futurelink/picnc-epm570/hardware/EPM570_LinuxCNC.kicad_pcb

## KiCad design hardware/EPM570_LinuxCNC.kicad_pcb (2025-01-06)

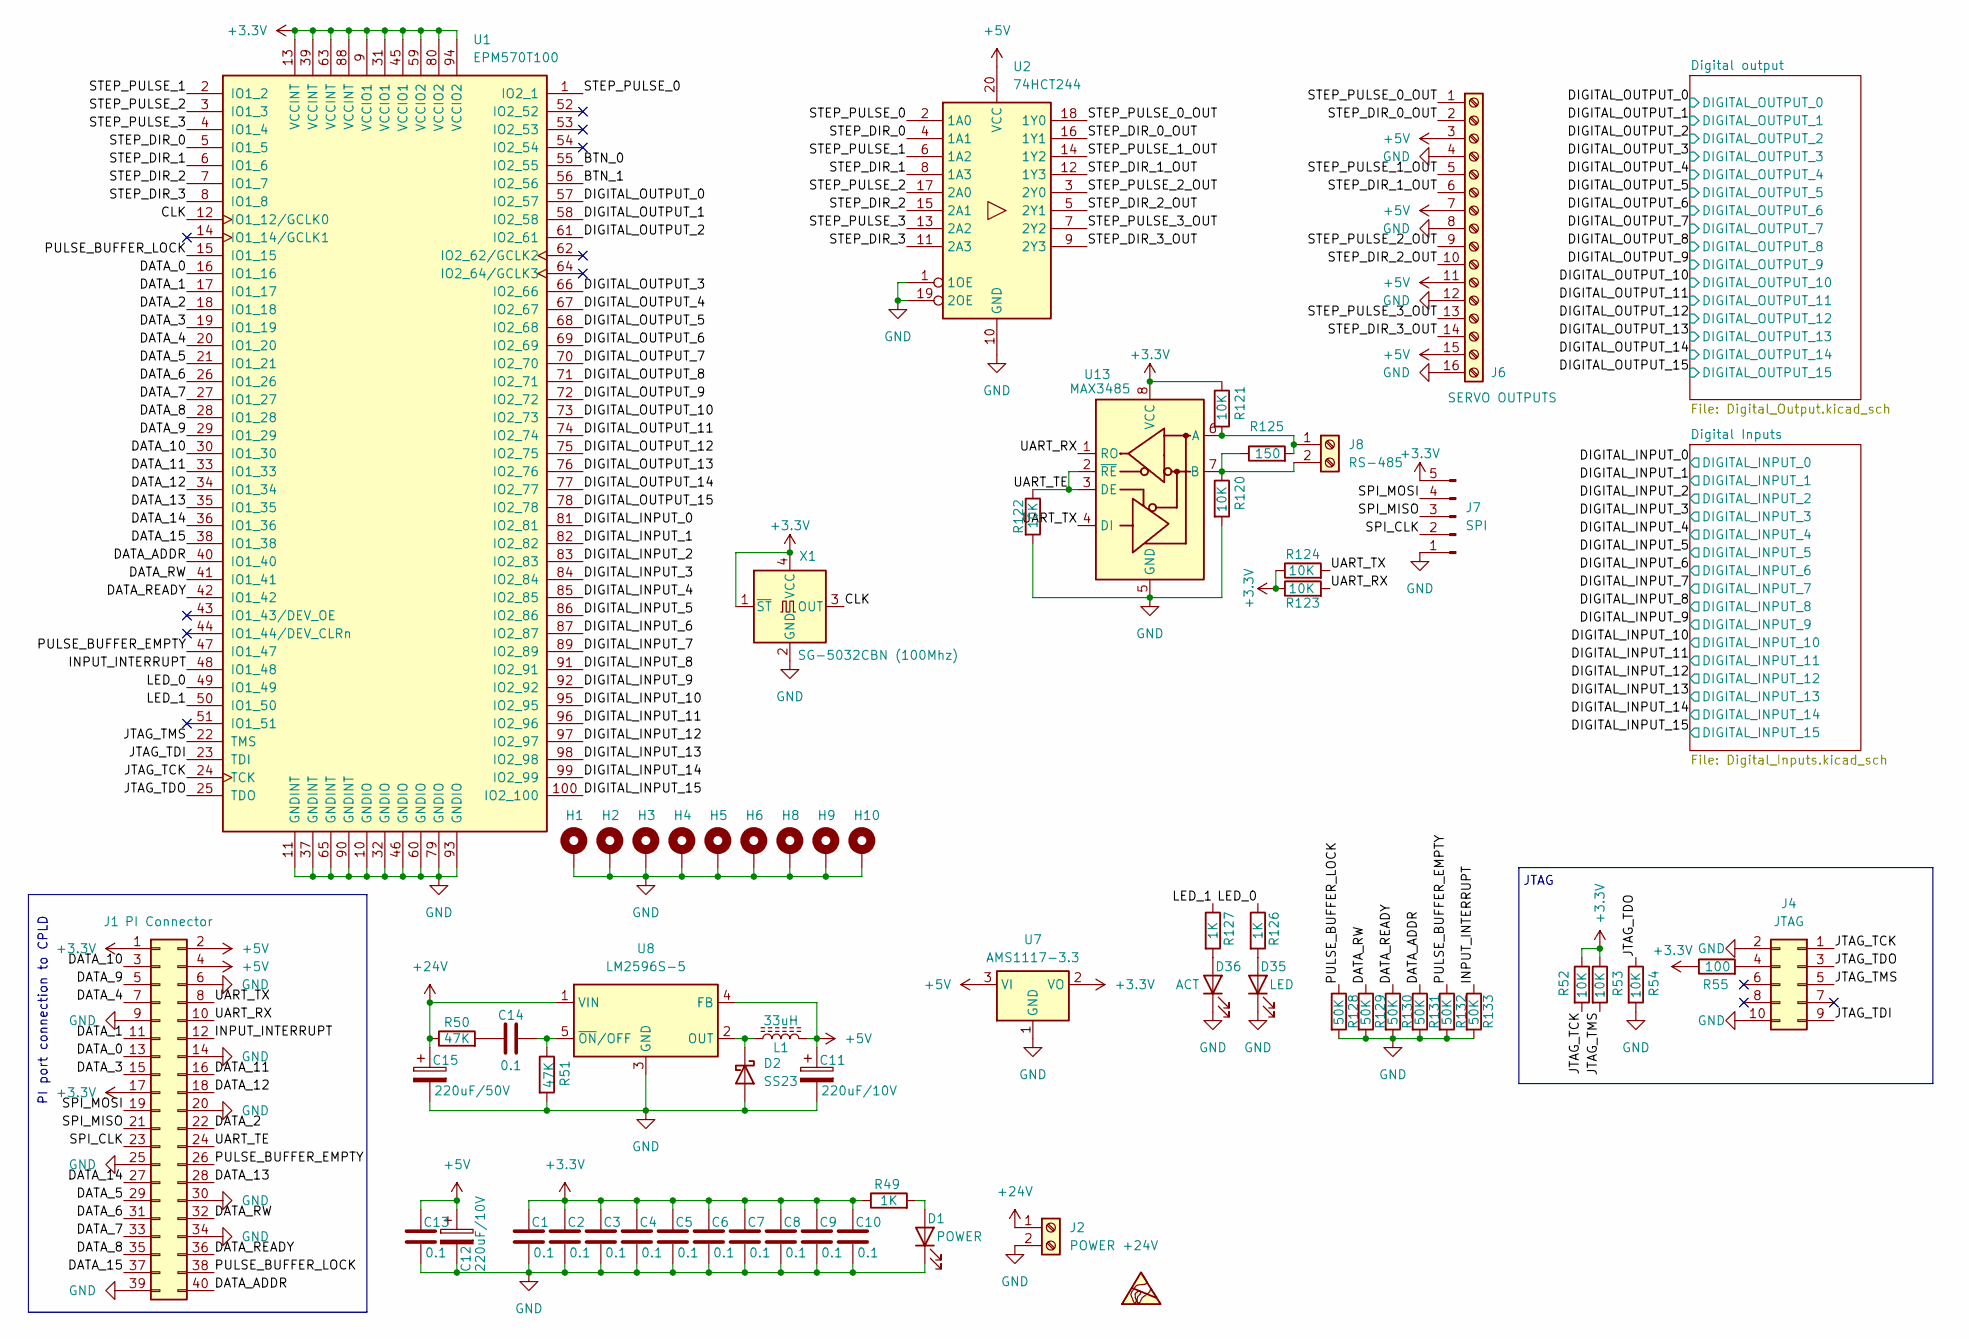
[picture p1: schematic EPM570_LinuxCNC.kicad_sch]

Parts:
C1, C2, C3, C4, C5, C6, C7, C8, C9, C10, C13, C14: 0.1; C_0603_1608Metric
C11, C12: 220uF/10V; CP_Elec_6.3x7.7
C15: 220uF/50V; CP_Elec_10x10
D1: POWER; LED_0603_1608Metric
D2: SS23; D_SMA
D35: LED; LED_0603_1608Metric
D36: ACT; LED_0603_1608Metric
H1, H2, H3, H4, H5, H6: MountingHole_Pad; MountingHole_2.7mm_M2.5_ISO7380_Pad
H8, H9, H10: MountingHole_Pad; MountingHole_3.2mm_M3_ISO7380_Pad
J1: PI Connector; PinSocket_2x20_P2.54mm_Vertical
J2: POWER +24V; TerminalBlock_Xinya_XY308-2.54-2P_1x02_P2.54mm_Horizontal
J4: JTAG; IDC-Header_2x05_P2.54mm_Vertical
J6: SERVO OUTPUTS; TerminalBlock_Xinya_XY308-2.54-16P_1x16_P2.54mm_Horizontal
J7: SPI; JST_EH_S5B-EH_1x05_P2.50mm_Horizontal
J8: RS-485; TerminalBlock_Xinya_XY308-2.54-2P_1x02_P2.54mm_Horizontal
L1: 33uH; L_10.4x10.4_H4.8
R49, R126, R127: 1K; R_0603_1608Metric
R50, R51: 47K; R_0603_1608Metric
R52, R53, R54, R120, R121, R122, R123, R124: 10K; R_0603_1608Metric
R55: 100; R_0603_1608Metric
R125: 150; R_0603_1608Metric
R128, R129, R130, R131, R132, R133: 50K; R_0603_1608Metric
U1: EPM570T100; LQFP-100_14x14mm_P0.5mm
U2: 74HCT244; Infineon_PG-DSO-20-32
U7: AMS1117-3.3; SOT-223-3_TabPin2
U8: LM2596S-5; TO-263-5_TabPin3
U13: MAX3485; SOIC-8_3.9x4.9mm_P1.27mm
X1: SG-5032CBN (100Mhz); Oscillator_SMD_SeikoEpson_SG8002LB-4Pin_5.0x3.2mm

Connections:
+3.3V: C1.1, C2.1, C3.1, C4.1, C5.1, C6.1, C7.1, C8.1, C9.1, C10.1, J1.1, J1.17, J7.5, R49.1, R52.1, R53.1, R55.1, R121.1, R123.1, R124.1, U1.9 (VCCIO1), U1.13 (VCCINT), U1.31 (VCCIO1), U1.39 (VCCINT), U1.45 (VCCIO1), U1.59 (VCCIO2), U1.63 (VCCINT), U1.80 (VCCIO2), U1.88 (VCCINT), U1.94 (VCCIO2), U7.2 (VO), U13.8 (VCC), X1.1 (~ST), X1.4 (VCC); also elsewhere on the board
+5V: C11.1, C12.1, C13.1, J1.2, J1.4, J6.3, J6.7, J6.11, J6.15, L1.2, U2.20 (VCC), U7.3 (VI), U8.4 (FB); also elsewhere on the board
+24V: C15.1, J2.1, R50.1, U8.1 (VIN)
/BTN_0: U1.55 (IO2_55)
/BTN_1: U1.56 (IO2_56)
/CLK: U1.12 (IO1_12/GCLK0), X1.3 (OUT)
/DATA_0: J1.13, U1.16 (IO1_16)
/DATA_1: J1.11, U1.17 (IO1_17)
/DATA_2: J1.22, U1.18 (IO1_18)
/DATA_3: J1.15, U1.19 (IO1_19)
/DATA_4: J1.7, U1.20 (IO1_20)
/DATA_5: J1.29, U1.21 (IO1_21)
/DATA_6: J1.31, U1.26 (IO1_26)
/DATA_7: J1.33, U1.27 (IO1_27)
/DATA_8: J1.35, U1.28 (IO1_28)
/DATA_9: J1.5, U1.29 (IO1_29)
/DATA_10: J1.3, U1.30 (IO1_30)
/DATA_11: J1.16, U1.33 (IO1_33)
/DATA_12: J1.18, U1.34 (IO1_34)
/DATA_13: J1.28, U1.35 (IO1_35)
/DATA_14: J1.27, U1.36 (IO1_36)
/DATA_15: J1.37, U1.38 (IO1_38)
/DATA_ADDR: J1.40, R131.1, U1.40 (IO1_40)
/DATA_READY: J1.36, R130.1, U1.42 (IO1_42)
/DATA_RW: J1.32, R129.1, U1.41 (IO1_41)
/DIGITAL_INPUT_0: U1.81 (IO2_81); also elsewhere on the board
/DIGITAL_INPUT_1: U1.82 (IO2_82); also elsewhere on the board
/DIGITAL_INPUT_2: U1.83 (IO2_83); also elsewhere on the board
/DIGITAL_INPUT_3: U1.84 (IO2_84); also elsewhere on the board
/DIGITAL_INPUT_4: U1.85 (IO2_85); also elsewhere on the board
/DIGITAL_INPUT_5: U1.86 (IO2_86); also elsewhere on the board
/DIGITAL_INPUT_6: U1.87 (IO2_87); also elsewhere on the board
/DIGITAL_INPUT_7: U1.89 (IO2_89); also elsewhere on the board
/DIGITAL_INPUT_8: U1.91 (IO2_91); also elsewhere on the board
/DIGITAL_INPUT_9: U1.92 (IO2_92); also elsewhere on the board
/DIGITAL_INPUT_10: U1.95 (IO2_95); also elsewhere on the board
/DIGITAL_INPUT_11: U1.96 (IO2_96); also elsewhere on the board
/DIGITAL_INPUT_12: U1.97 (IO2_97); also elsewhere on the board
/DIGITAL_INPUT_13: U1.98 (IO2_98); also elsewhere on the board
/DIGITAL_INPUT_14: U1.99 (IO2_99); also elsewhere on the board
/DIGITAL_INPUT_15: U1.100 (IO2_100); also elsewhere on the board
/DIGITAL_OUTPUT_0: U1.57 (IO2_57); also elsewhere on the board
/DIGITAL_OUTPUT_1: U1.58 (IO2_58); also elsewhere on the board
/DIGITAL_OUTPUT_2: U1.61 (IO2_61); also elsewhere on the board
/DIGITAL_OUTPUT_3: U1.66 (IO2_66); also elsewhere on the board
/DIGITAL_OUTPUT_4: U1.67 (IO2_67); also elsewhere on the board
/DIGITAL_OUTPUT_5: U1.68 (IO2_68); also elsewhere on the board
/DIGITAL_OUTPUT_6: U1.69 (IO2_69); also elsewhere on the board
/DIGITAL_OUTPUT_7: U1.70 (IO2_70); also elsewhere on the board
/DIGITAL_OUTPUT_8: U1.71 (IO2_71); also elsewhere on the board
/DIGITAL_OUTPUT_9: U1.72 (IO2_72); also elsewhere on the board
/DIGITAL_OUTPUT_10: U1.73 (IO2_73); also elsewhere on the board
/DIGITAL_OUTPUT_11: U1.74 (IO2_74); also elsewhere on the board
/DIGITAL_OUTPUT_12: U1.75 (IO2_75); also elsewhere on the board
/DIGITAL_OUTPUT_13: U1.76 (IO2_76); also elsewhere on the board
/DIGITAL_OUTPUT_14: U1.77 (IO2_77); also elsewhere on the board
/DIGITAL_OUTPUT_15: U1.78 (IO2_78); also elsewhere on the board
/INPUT_INTERRUPT: J1.12, R133.1, U1.48 (IO1_48)
/JTAG_TCK: J4.1, R52.2, U1.24 (TCK)
/JTAG_TDI: J4.9, U1.23 (TDI)
/JTAG_TDO: J4.3, R54.1, U1.25 (TDO)
/JTAG_TMS: J4.5, R53.2, U1.22 (TMS)
/LED_0: R126.1, U1.49 (IO1_49)
/LED_1: R127.1, U1.50 (IO1_50)
/PULSE_BUFFER_EMPTY: J1.26, R132.1, U1.47 (IO1_47)
/PULSE_BUFFER_LOCK: J1.38, R128.1, U1.15 (IO1_15)
/SPI_CLK: J1.23, J7.2
/SPI_MISO: J1.21, J7.3
/SPI_MOSI: J1.19, J7.4
/STEP_DIR_0: U1.5 (IO1_5), U2.4 (1A1)
/STEP_DIR_0_OUT: J6.2, U2.16 (1Y1)
/STEP_DIR_1: U1.6 (IO1_6), U2.8 (1A3)
/STEP_DIR_1_OUT: J6.6, U2.12 (1Y3)
/STEP_DIR_2: U1.7 (IO1_7), U2.15 (2A1)
/STEP_DIR_2_OUT: J6.10, U2.5 (2Y1)
/STEP_DIR_3: U1.8 (IO1_8), U2.11 (2A3)
/STEP_DIR_3_OUT: J6.14, U2.9 (2Y3)
/STEP_PULSE_0: U1.1 (IO2_1), U2.2 (1A0)
/STEP_PULSE_0_OUT: J6.1, U2.18 (1Y0)
/STEP_PULSE_1: U1.2 (IO1_2), U2.6 (1A2)
/STEP_PULSE_1_OUT: J6.5, U2.14 (1Y2)
/STEP_PULSE_2: U1.3 (IO1_3), U2.17 (2A0)
/STEP_PULSE_2_OUT: J6.9, U2.3 (2Y0)
/STEP_PULSE_3: U1.4 (IO1_4), U2.13 (2A2)
/STEP_PULSE_3_OUT: J6.13, U2.7 (2Y2)
/UART_RX: J1.10, R123.2, U13.1 (RO)
/UART_TE: J1.24, R122.1, U13.2 (~RE), U13.3 (DE)
/UART_TX: J1.8, R124.2, U13.4 (DI)
GND: C1.2, C2.2, C3.2, C4.2, C5.2, C6.2, C7.2, C8.2, C9.2, C10.2, C11.2, C12.2, C13.2, C15.2, D1.1 (K), D2.2 (A), D35.1 (K), D36.1 (K), H1.1, H2.1, H3.1, H4.1, H5.1, H6.1, H8.1, H9.1, H10.1, J1.6, J1.9, J1.14, J1.20, J1.25, J1.30, J1.34, J1.39, J2.2, J4.2, J4.10, J6.4, J6.8, J6.12, J6.16, J7.1, R51.2, R54.2, R120.2, R122.2, R128.2, R129.2, R130.2, R131.2, R132.2, R133.2, U1.10 (GNDIO), U1.11 (GNDINT), U1.32 (GNDIO), U1.37 (GNDINT), U1.46 (GNDIO), U1.60 (GNDIO), U1.65 (GNDINT), U1.79 (GNDIO), U1.90 (GNDINT), U1.93 (GNDIO), U2.1 (1OE), U2.10 (GND), U2.19 (2OE), U7.1 (GND), U8.3 (GND), U13.5 (GND), X1.2 (GND); also elsewhere on the board
unnamed: C14.1, R50.2
unnamed: D1.2 (A), R49.2
unnamed: D2.1 (K), L1.1, U8.2 (OUT)
unnamed: D35.2 (A), R126.2
unnamed: D36.2 (A), R127.2
unnamed: J4.4, R55.2
unnamed: J8.1, R121.2, R125.2, U13.6 (A)
unnamed: J8.2, R120.1, R125.1, U13.7 (B)
unnamed: C14.2, R51.1, U8.5 (~ON/OFF)

Notes on the sheet:
PI port connection to CPLD
JTAG

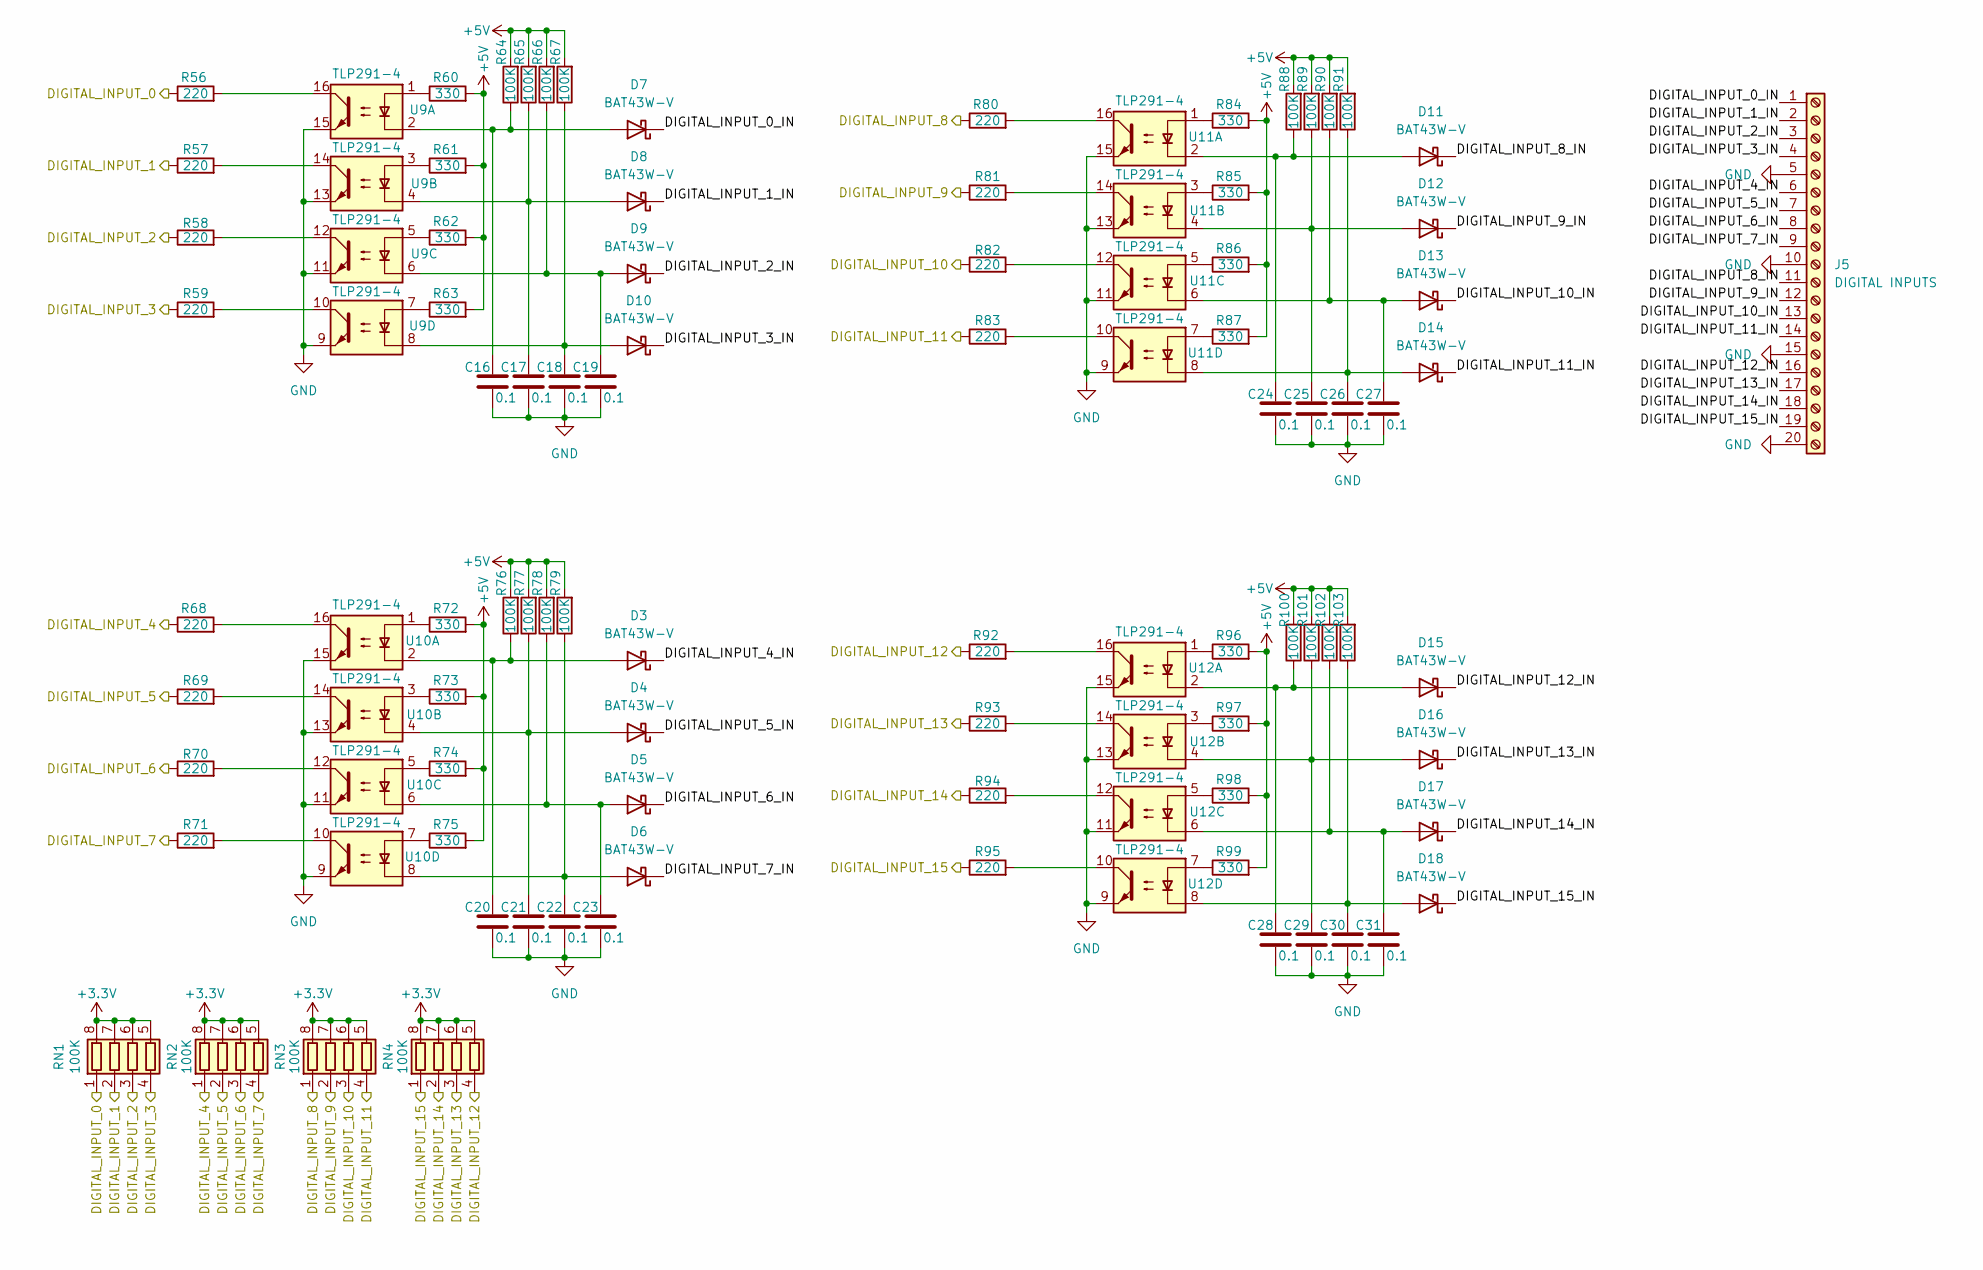
[picture p2: schematic Digital_Inputs.kicad_sch]

Parts:
C16, C17, C18, C19, C20, C21, C22, C23, C24, C25, C26, C27, C28, C29, C30, C31: 0.1; C_0603_1608Metric
D3, D4, D5, D6, D7, D8, D9, D10, D11, D12, D13, D14, D15, D16, D17, D18: BAT43W-V; D_SOD-323
J5: DIGITAL INPUTS; TerminalBlock_Xinya_XY308-2.54-20P_1x20_P2.54mm_Horizontal
R56, R57, R58, R59, R68, R69, R70, R71, R80, R81, R82, R83, R92, R93, R94, R95: 220; R_0603_1608Metric
R60, R61, R62, R63, R72, R73, R74, R75, R84, R85, R86, R87, R96, R97, R98, R99: 330; R_0603_1608Metric
R64, R65, R66, R67, R76, R77, R78, R79, R88, R89, R90, R91, R100, R101, R102, R103: 100K; R_0603_1608Metric
RN1, RN2, RN3, RN4: 100K; R_Array_Convex_4x0603
U9, U10, U11, U12: TLP291-4; SOIC-16_4.55x10.3mm_P1.27mm

Connections:
+3.3V: RN1.5 (R4.2), RN1.6 (R3.2), RN1.7 (R2.2), RN1.8 (R1.2), RN2.5 (R4.2), RN2.6 (R3.2), RN2.7 (R2.2), RN2.8 (R1.2), RN3.5 (R4.2), RN3.6 (R3.2), RN3.7 (R2.2), RN3.8 (R1.2), RN4.5 (R4.2), RN4.6 (R3.2), RN4.7 (R2.2), RN4.8 (R1.2); also elsewhere on the board
+5V: R60.2, R61.2, R62.2, R63.2, R64.2, R65.2, R66.2, R67.2, R72.2, R73.2, R74.2, R75.2, R76.2, R77.2, R78.2, R79.2, R84.2, R85.2, R86.2, R87.2, R88.2, R89.2, R90.2, R91.2, R96.2, R97.2, R98.2, R99.2, R100.2, R101.2, R102.2, R103.2; also elsewhere on the board
/DIGITAL_INPUT_0: R56.1, RN1.1 (R1.1); also elsewhere on the board
/DIGITAL_INPUT_1: R57.1, RN1.2 (R2.1); also elsewhere on the board
/DIGITAL_INPUT_2: R58.1, RN1.3 (R3.1); also elsewhere on the board
/DIGITAL_INPUT_3: R59.1, RN1.4 (R4.1); also elsewhere on the board
/DIGITAL_INPUT_4: R68.1, RN2.1 (R1.1); also elsewhere on the board
/DIGITAL_INPUT_5: R69.1, RN2.2 (R2.1); also elsewhere on the board
/DIGITAL_INPUT_6: R70.1, RN2.3 (R3.1); also elsewhere on the board
/DIGITAL_INPUT_7: R71.1, RN2.4 (R4.1); also elsewhere on the board
/DIGITAL_INPUT_8: R80.1, RN3.1 (R1.1); also elsewhere on the board
/DIGITAL_INPUT_9: R81.1, RN3.2 (R2.1); also elsewhere on the board
/DIGITAL_INPUT_10: R82.1, RN3.3 (R3.1); also elsewhere on the board
/DIGITAL_INPUT_11: R83.1, RN3.4 (R4.1); also elsewhere on the board
/DIGITAL_INPUT_12: R92.1, RN4.4 (R4.1); also elsewhere on the board
/DIGITAL_INPUT_13: R93.1, RN4.3 (R3.1); also elsewhere on the board
/DIGITAL_INPUT_14: R94.1, RN4.2 (R2.1); also elsewhere on the board
/DIGITAL_INPUT_15: R95.1, RN4.1 (R1.1); also elsewhere on the board
/Digital Inputs/DIGITAL_INPUT_0_IN: D7.1 (K), J5.1
/Digital Inputs/DIGITAL_INPUT_1_IN: D8.1 (K), J5.2
/Digital Inputs/DIGITAL_INPUT_2_IN: D9.1 (K), J5.3
/Digital Inputs/DIGITAL_INPUT_3_IN: D10.1 (K), J5.4
/Digital Inputs/DIGITAL_INPUT_4_IN: D3.1 (K), J5.6
/Digital Inputs/DIGITAL_INPUT_5_IN: D4.1 (K), J5.7
/Digital Inputs/DIGITAL_INPUT_6_IN: D5.1 (K), J5.8
/Digital Inputs/DIGITAL_INPUT_7_IN: D6.1 (K), J5.9
/Digital Inputs/DIGITAL_INPUT_8_IN: D11.1 (K), J5.11
/Digital Inputs/DIGITAL_INPUT_9_IN: D12.1 (K), J5.12
/Digital Inputs/DIGITAL_INPUT_10_IN: D13.1 (K), J5.13
/Digital Inputs/DIGITAL_INPUT_11_IN: D14.1 (K), J5.14
/Digital Inputs/DIGITAL_INPUT_12_IN: D15.1 (K), J5.16
/Digital Inputs/DIGITAL_INPUT_13_IN: D16.1 (K), J5.17
/Digital Inputs/DIGITAL_INPUT_14_IN: D17.1 (K), J5.18
/Digital Inputs/DIGITAL_INPUT_15_IN: D18.1 (K), J5.19
GND: C16.2, C17.2, C18.2, C19.2, C20.2, C21.2, C22.2, C23.2, C24.2, C25.2, C26.2, C27.2, C28.2, C29.2, C30.2, C31.2, J5.5, J5.10, J5.15, J5.20, U9.9, U9.11, U9.13, U9.15, U10.9, U10.11, U10.13, U10.15, U11.9, U11.11, U11.13, U11.15, U12.9, U12.11, U12.13, U12.15; also elsewhere on the board
unnamed: C20.1, D3.2 (A), R76.1, U10.2
unnamed: C21.1, D4.2 (A), R77.1, U10.4
unnamed: C23.1, D5.2 (A), R78.1, U10.6
unnamed: C22.1, D6.2 (A), R79.1, U10.8
unnamed: C16.1, D7.2 (A), R64.1, U9.2
unnamed: C17.1, D8.2 (A), R65.1, U9.4
unnamed: C19.1, D9.2 (A), R66.1, U9.6
unnamed: C18.1, D10.2 (A), R67.1, U9.8
unnamed: C24.1, D11.2 (A), R88.1, U11.2
unnamed: C25.1, D12.2 (A), R89.1, U11.4
unnamed: C27.1, D13.2 (A), R90.1, U11.6
unnamed: C26.1, D14.2 (A), R91.1, U11.8
unnamed: C28.1, D15.2 (A), R100.1, U12.2
unnamed: C29.1, D16.2 (A), R101.1, U12.4
unnamed: C31.1, D17.2 (A), R102.1, U12.6
unnamed: C30.1, D18.2 (A), R103.1, U12.8
unnamed: R56.2, U9.16
unnamed: R57.2, U9.14
unnamed: R58.2, U9.12
unnamed: R59.2, U9.10
unnamed: R60.1, U9.1
unnamed: R61.1, U9.3
unnamed: R62.1, U9.5
unnamed: R63.1, U9.7
unnamed: R68.2, U10.16
unnamed: R69.2, U10.14
unnamed: R70.2, U10.12
unnamed: R71.2, U10.10
unnamed: R72.1, U10.1
unnamed: R73.1, U10.3
unnamed: R74.1, U10.5
unnamed: R75.1, U10.7
unnamed: R80.2, U11.16
unnamed: R81.2, U11.14
unnamed: R82.2, U11.12
unnamed: R83.2, U11.10
unnamed: R84.1, U11.1
unnamed: R85.1, U11.3
unnamed: R86.1, U11.5
unnamed: R87.1, U11.7
unnamed: R92.2, U12.16
unnamed: R93.2, U12.14
unnamed: R94.2, U12.12
unnamed: R95.2, U12.10
unnamed: R96.1, U12.1
unnamed: R97.1, U12.3
unnamed: R98.1, U12.5
unnamed: R99.1, U12.7

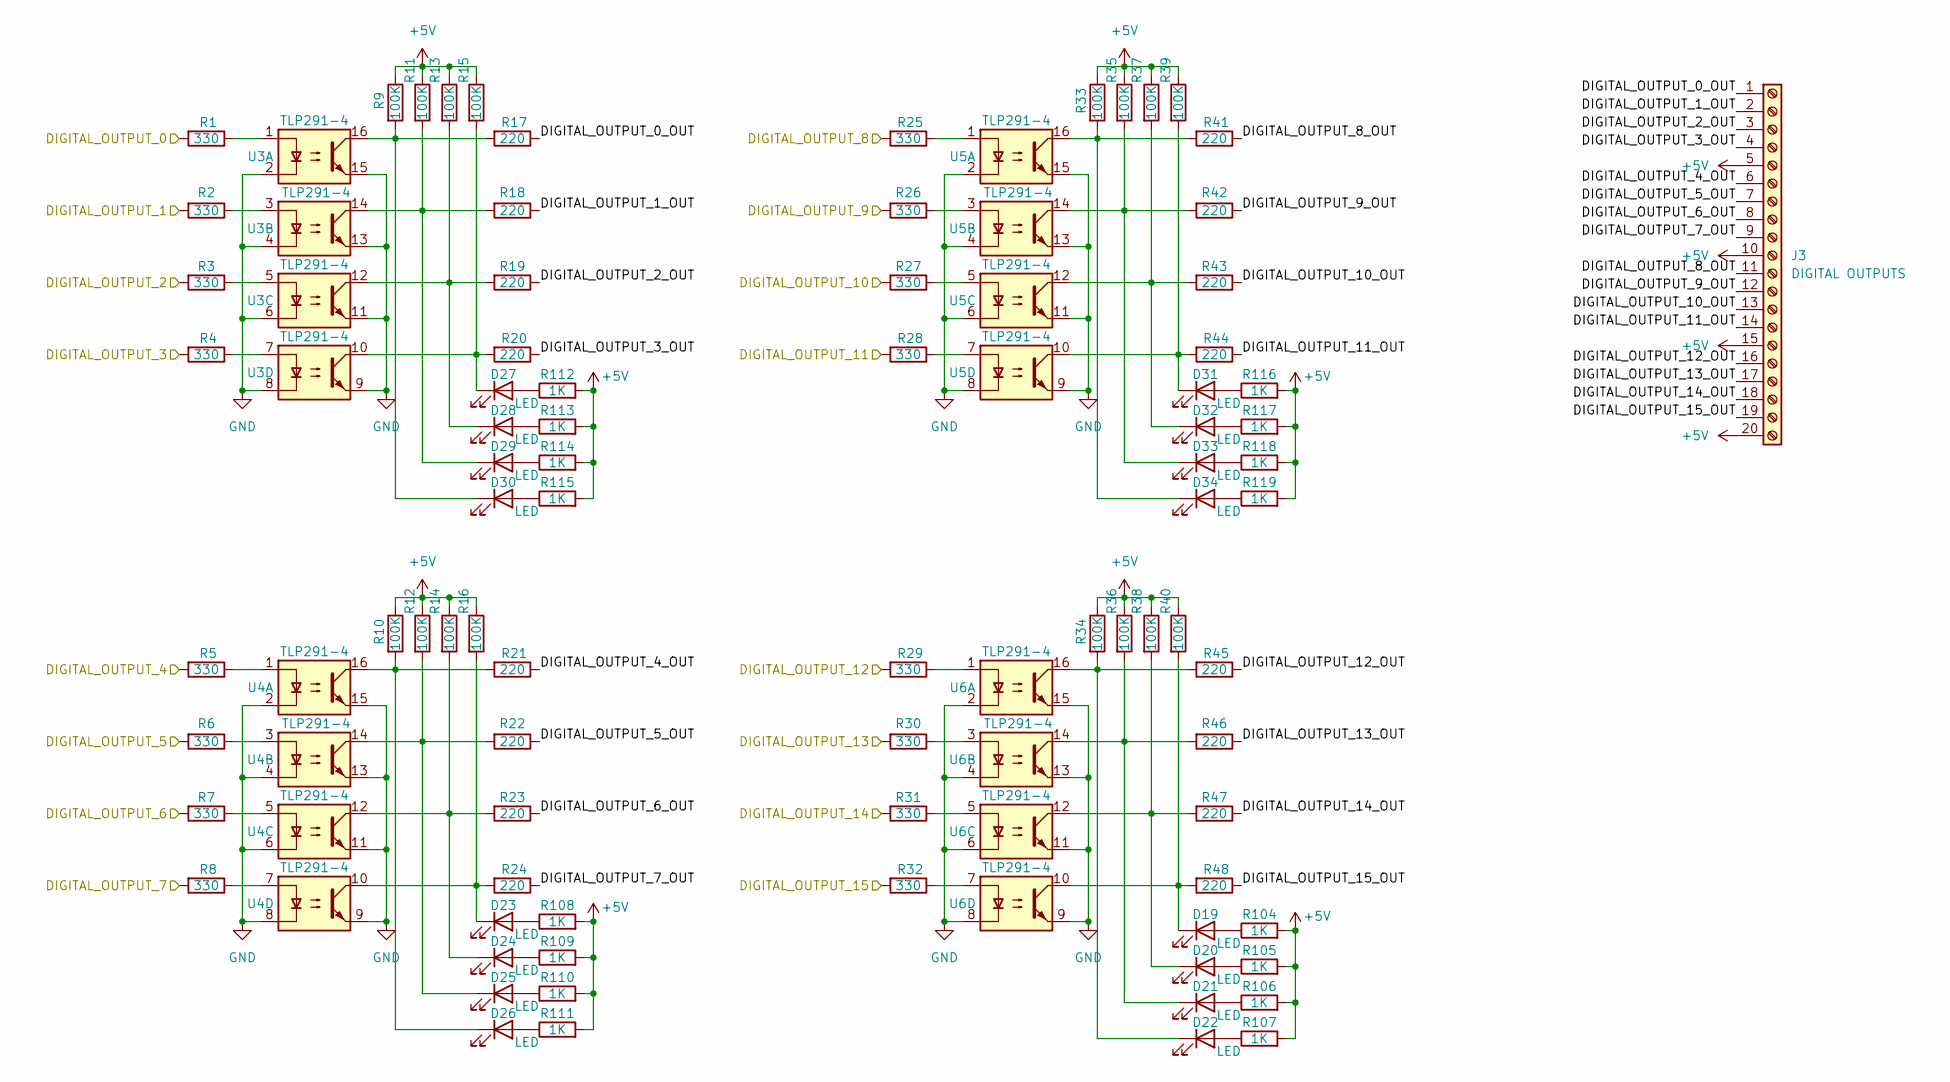
[picture p3: schematic Digital_Output.kicad_sch]

Parts:
D19, D20, D21, D22, D23, D24, D25, D26, D27, D28, D29, D30, D31, D32, D33, D34: LED; LED_0603_1608Metric
J3: DIGITAL OUTPUTS; TerminalBlock_Xinya_XY308-2.54-20P_1x20_P2.54mm_Horizontal
R1, R2, R3, R4, R5, R6, R7, R8, R25, R26, R27, R28, R29, R30, R31, R32: 330; R_0603_1608Metric
R9, R10, R11, R12, R13, R14, R15, R16, R33, R34, R35, R36, R37, R38, R39, R40: 100K; R_0603_1608Metric
R17, R18, R19, R20, R21, R22, R23, R24, R41, R42, R43, R44, R45, R46, R47, R48: 220; R_0603_1608Metric
R104, R105, R106, R107, R108, R109, R110, R111, R112, R113, R114, R115, R116, R117, R118, R119: 1K; R_0603_1608Metric
U3, U4, U5, U6: TLP291-4; SOIC-16_4.55x10.3mm_P1.27mm

Connections:
+5V: J3.5, J3.10, J3.15, J3.20, R9.1, R10.1, R11.1, R12.1, R13.1, R14.1, R15.1, R16.1, R33.1, R34.1, R35.1, R36.1, R37.1, R38.1, R39.1, R40.1, R104.2, R105.2, R106.2, R107.2, R108.2, R109.2, R110.2, R111.2, R112.2, R113.2, R114.2, R115.2, R116.2, R117.2, R118.2, R119.2; also elsewhere on the board
/DIGITAL_OUTPUT_0: R1.2; also elsewhere on the board
/DIGITAL_OUTPUT_1: R2.2; also elsewhere on the board
/DIGITAL_OUTPUT_2: R3.2; also elsewhere on the board
/DIGITAL_OUTPUT_3: R4.2; also elsewhere on the board
/DIGITAL_OUTPUT_4: R5.2; also elsewhere on the board
/DIGITAL_OUTPUT_5: R6.2; also elsewhere on the board
/DIGITAL_OUTPUT_6: R7.2; also elsewhere on the board
/DIGITAL_OUTPUT_7: R8.2; also elsewhere on the board
/DIGITAL_OUTPUT_8: R25.2; also elsewhere on the board
/DIGITAL_OUTPUT_9: R26.2; also elsewhere on the board
/DIGITAL_OUTPUT_10: R27.2; also elsewhere on the board
/DIGITAL_OUTPUT_11: R28.2; also elsewhere on the board
/DIGITAL_OUTPUT_12: R29.2; also elsewhere on the board
/DIGITAL_OUTPUT_13: R30.2; also elsewhere on the board
/DIGITAL_OUTPUT_14: R31.2; also elsewhere on the board
/DIGITAL_OUTPUT_15: R32.2; also elsewhere on the board
/Digital output/DIGITAL_OUTPUT_0_OUT: J3.1, R17.1
/Digital output/DIGITAL_OUTPUT_1_OUT: J3.2, R18.1
/Digital output/DIGITAL_OUTPUT_2_OUT: J3.3, R19.1
/Digital output/DIGITAL_OUTPUT_3_OUT: J3.4, R20.1
/Digital output/DIGITAL_OUTPUT_4_OUT: J3.6, R21.1
/Digital output/DIGITAL_OUTPUT_5_OUT: J3.7, R22.1
/Digital output/DIGITAL_OUTPUT_6_OUT: J3.8, R23.1
/Digital output/DIGITAL_OUTPUT_7_OUT: J3.9, R24.1
/Digital output/DIGITAL_OUTPUT_8_OUT: J3.11, R41.1
/Digital output/DIGITAL_OUTPUT_9_OUT: J3.12, R42.1
/Digital output/DIGITAL_OUTPUT_10_OUT: J3.13, R43.1
/Digital output/DIGITAL_OUTPUT_11_OUT: J3.14, R44.1
/Digital output/DIGITAL_OUTPUT_12_OUT: J3.16, R45.1
/Digital output/DIGITAL_OUTPUT_13_OUT: J3.17, R46.1
/Digital output/DIGITAL_OUTPUT_14_OUT: J3.18, R47.1
/Digital output/DIGITAL_OUTPUT_15_OUT: J3.19, R48.1
GND: U3.2, U3.4, U3.6, U3.8, U3.9, U3.11, U3.13, U3.15, U4.2, U4.4, U4.6, U4.8, U4.9, U4.11, U4.13, U4.15, U5.2, U5.4, U5.6, U5.8, U5.9, U5.11, U5.13, U5.15, U6.2, U6.4, U6.6, U6.8, U6.9, U6.11, U6.13, U6.15; also elsewhere on the board
unnamed: D19.2 (A), R104.1
unnamed: D19.1 (K), R40.2, R48.2, U6.10
unnamed: D20.2 (A), R105.1
unnamed: D20.1 (K), R38.2, R47.2, U6.12
unnamed: D21.2 (A), R106.1
unnamed: D21.1 (K), R36.2, R46.2, U6.14
unnamed: D22.2 (A), R107.1
unnamed: D22.1 (K), R34.2, R45.2, U6.16
unnamed: D23.2 (A), R108.1
unnamed: D23.1 (K), R16.2, R24.2, U4.10
unnamed: D24.2 (A), R109.1
unnamed: D24.1 (K), R14.2, R23.2, U4.12
unnamed: D25.2 (A), R110.1
unnamed: D25.1 (K), R12.2, R22.2, U4.14
unnamed: D26.2 (A), R111.1
unnamed: D26.1 (K), R10.2, R21.2, U4.16
unnamed: D27.2 (A), R112.1
unnamed: D27.1 (K), R15.2, R20.2, U3.10
unnamed: D28.2 (A), R113.1
unnamed: D28.1 (K), R13.2, R19.2, U3.12
unnamed: D29.2 (A), R114.1
unnamed: D29.1 (K), R11.2, R18.2, U3.14
unnamed: D30.2 (A), R115.1
unnamed: D30.1 (K), R9.2, R17.2, U3.16
unnamed: D31.2 (A), R116.1
unnamed: D31.1 (K), R39.2, R44.2, U5.10
unnamed: D32.2 (A), R117.1
unnamed: D32.1 (K), R37.2, R43.2, U5.12
unnamed: D33.2 (A), R118.1
unnamed: D33.1 (K), R35.2, R42.2, U5.14
unnamed: D34.2 (A), R119.1
unnamed: D34.1 (K), R33.2, R41.2, U5.16
unnamed: R1.1, U3.1
unnamed: R2.1, U3.3
unnamed: R3.1, U3.5
unnamed: R4.1, U3.7
unnamed: R5.1, U4.1
unnamed: R6.1, U4.3
unnamed: R7.1, U4.5
unnamed: R8.1, U4.7
unnamed: R25.1, U5.1
unnamed: R26.1, U5.3
unnamed: R27.1, U5.5
unnamed: R28.1, U5.7
unnamed: R29.1, U6.1
unnamed: R30.1, U6.3
unnamed: R31.1, U6.5
unnamed: R32.1, U6.7

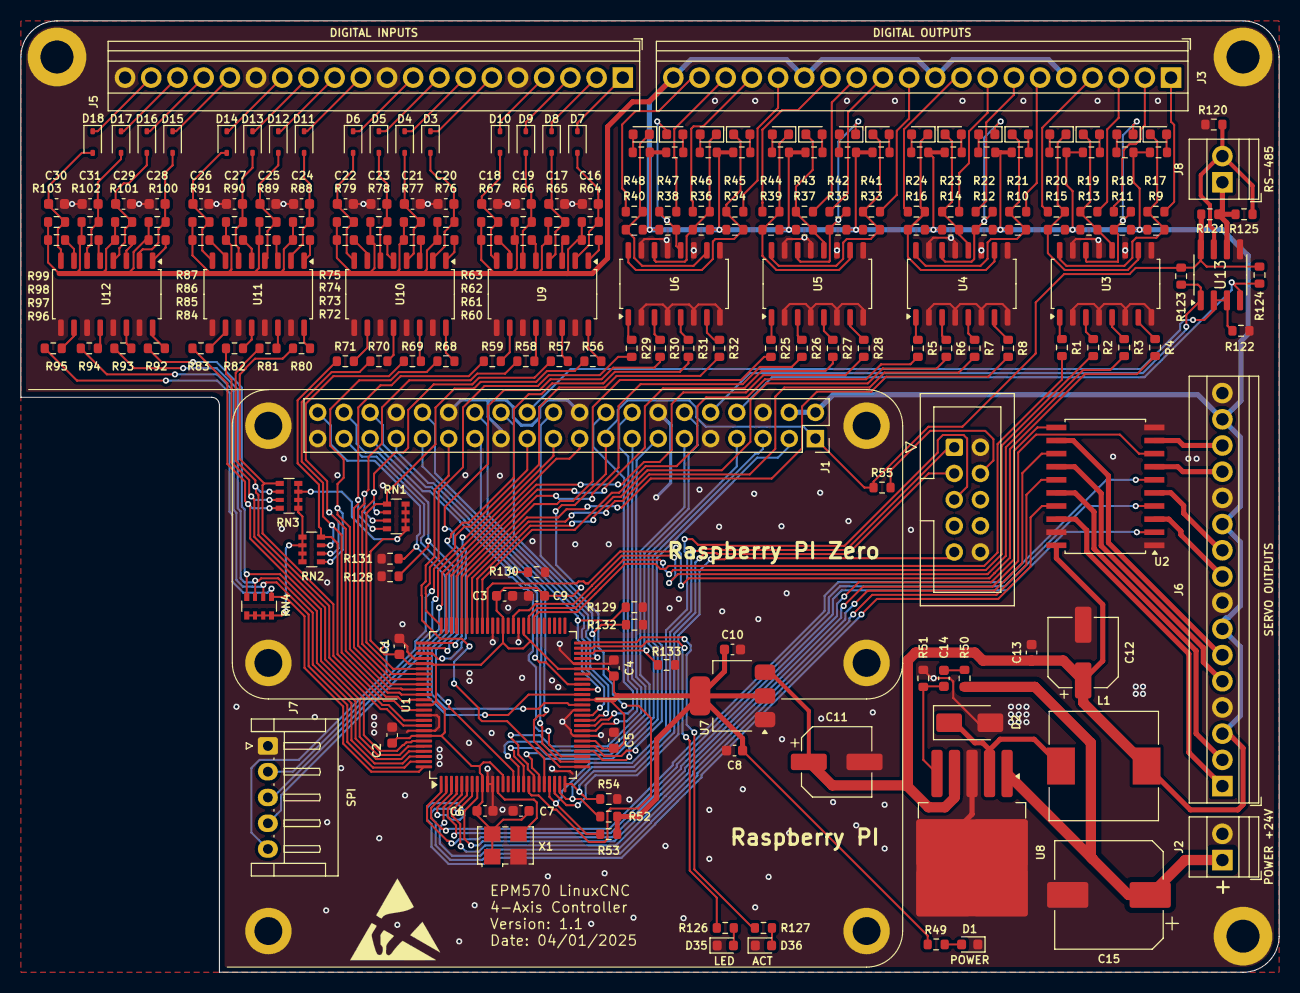
[picture p4: board EPM570_LinuxCNC.kicad_pcb from above]

Board: 2 copper layers, 122.0 x 92.2 mm, 236 parts (0 on the bottom side), 224 nets.
